LukeKim3835/embodied-robotic-companion-adhd/docs/README.md

# docs

Visual assets and supporting materials for the project.

## Present

- `images/demo.gif` — short demo clip (3× speed) embedded in the top-level README
- `images/demo.mp4` — full-resolution compressed demo video
- `architecture.svg` — system / data-flow diagram
- `poster.pdf` — A3 research poster
- `dissertation.pdf` — full BSc dissertation (checked: only aggregated, de-identified data)

## Robot photos

- `images/system_look.jpeg` / `images/system_home.jpeg` — robot with the laptop task (look / standby)
- `images/look.jpeg` / `images/home.jpeg` — lamp head close-ups (look / standby)

To add the robot photo, drop the file into `images/` and reference it in the top-level
README next to the demo.
