LukeKim3835/embodied-robotic-companion-adhd/hardware/cad/README.md

# 3D-printed parts

STL files for the custom 3D-printed parts.

- **Custom lamp head** — [`lamp_head.stl`](lamp_head.stl)
- **2-axis SG90 gimbal** — from GrabCAD (not re-hosted here to respect the original license):
  https://grabcad.com/library/gimbal-2-axis-with-sg90-mini-servo-3d-printing-1
