LukeKim3835/embodied-robotic-companion-adhd/analysis/data/figures/fig_distraction_profile.png

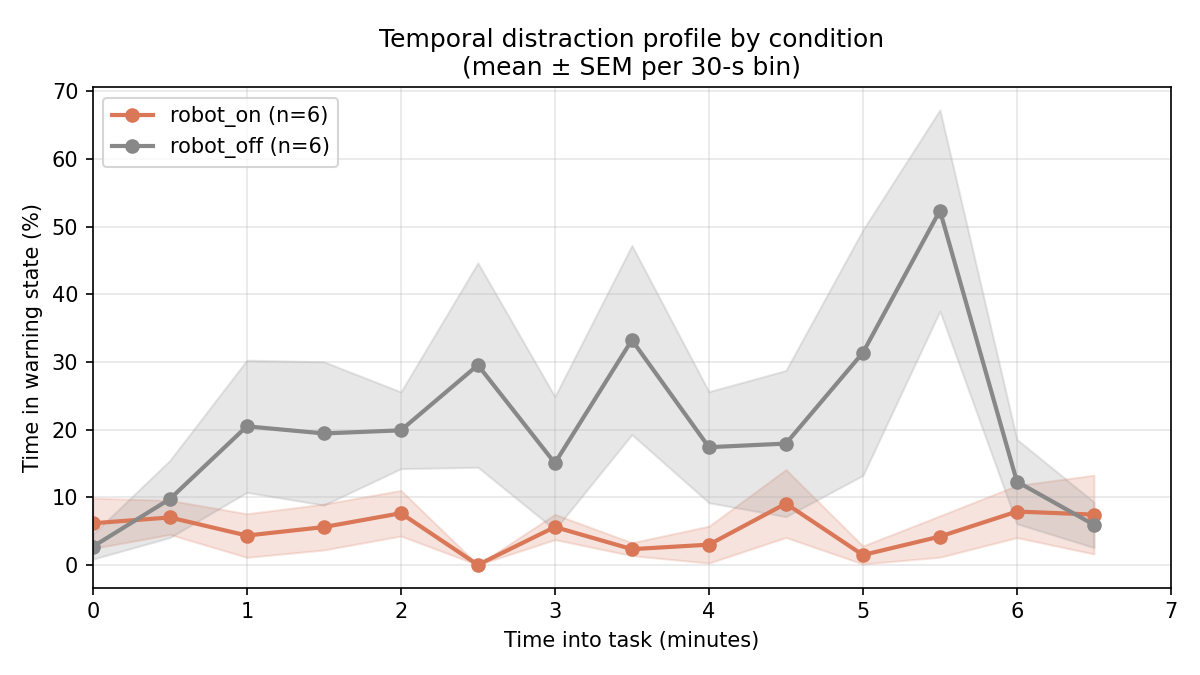
analysis/data/figures/fig_distraction_profile.png
