LukeKim3835/embodied-robotic-companion-adhd/analysis/data/figures/fig_perceived_duration.png

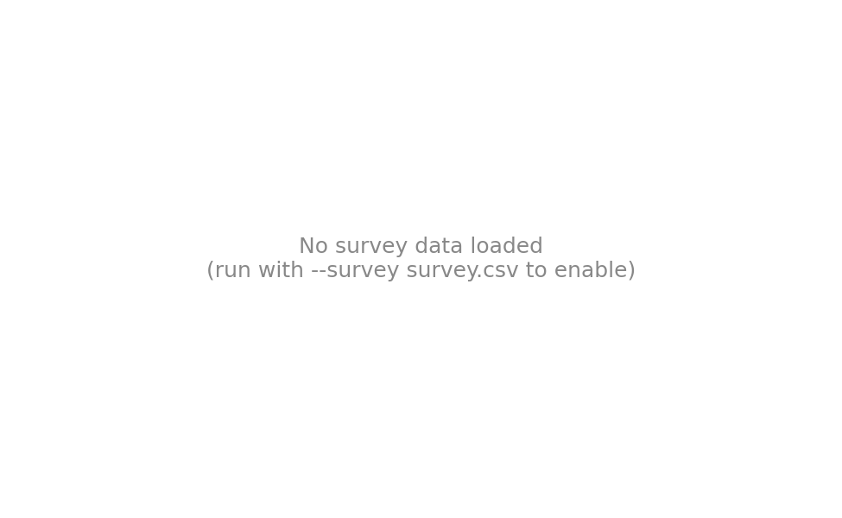
analysis/data/figures/fig_perceived_duration.png
