LukeKim3835/embodied-robotic-companion-adhd/analysis/data/figures/fig_warning_rates.png

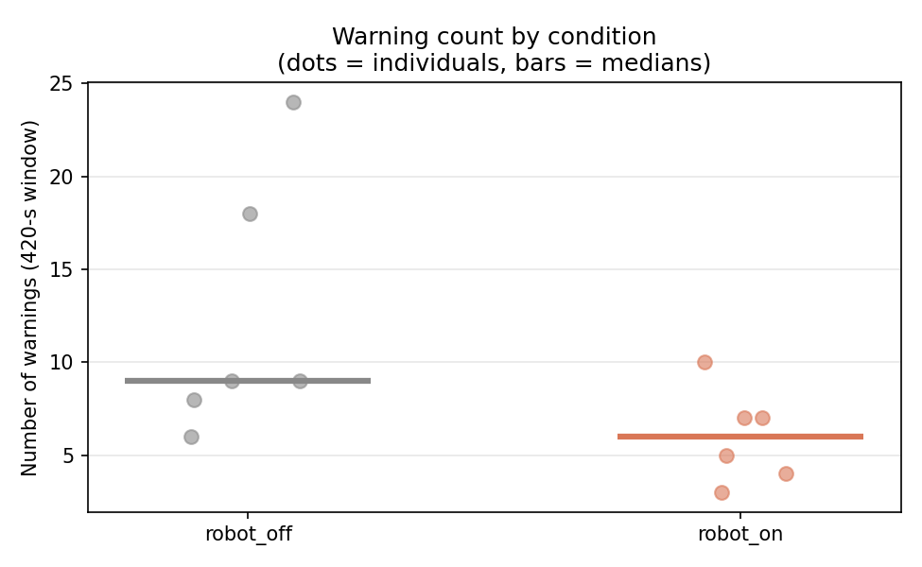
analysis/data/figures/fig_warning_rates.png
