LukeKim3835/embodied-robotic-companion-adhd/hardware/cad/lamp_head.stl

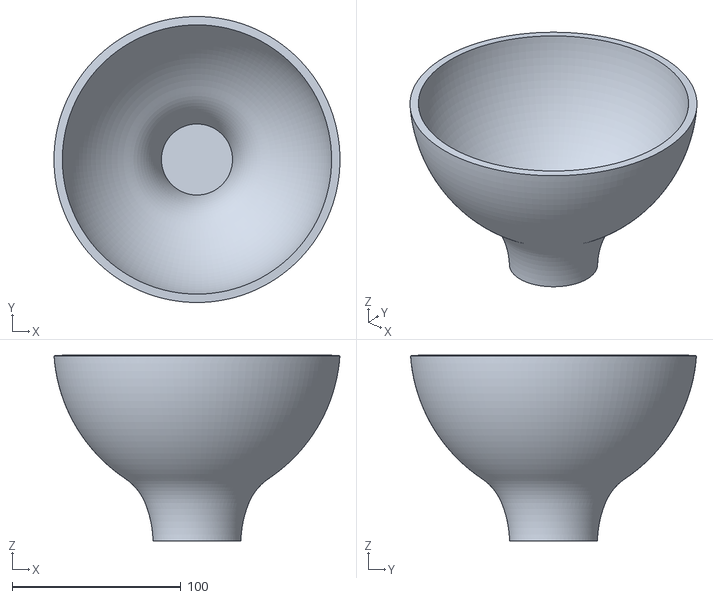
[picture p21: CAD file, 2026-07-04]
hardware/cad/lamp_head.stl
169.7 x 169.7 x 110.1
