LukeKim3835/embodied-robotic-companion-adhd/(commit log)

2026-07-04 Initial commit: embodied attention-support robot (dissertation)
    Vision pipeline (BlazePose + YOLOv11n), TCP client/server robot control,
    and de-identified user-study analysis. No raw participant data included.
    [condition_summary.csv, per_participant.csv]
2026-07-04 Add Raspberry Pi control code, analysis script, demo, poster, architecture
    - src/raspberry_pi/: TCP server (main_v3), gimbal + PWM test scripts
    - analysis/: real batch analysis script (sessions_analysis.py)
    - docs/: demo GIF + compressed MP4, system architecture diagram, research poster
2026-07-04 Add dissertation PDF and link project materials in README
    Reviewed for participant privacy: demographics are aggregated and quotes use
    pseudonymous codes only; no identifiable participant data.
2026-07-04 Add lamp head STL and finalise cad README
    [lamp_head.stl]
